MichaelRFairhurst/solver_3/constants.scad

/**
 * Copyright 2018 Mike and Nathan Fairhurst. See LICENSE for licensing.
 */

// Constants to be used by all models
cube_size = 56.5;
$tol = 0.4;
layer_count = 3;
cube_rounding = 1;
servo_block_size=[26.5,15,30];
servo_flange_length=13;
servo_flange_thickness=1.5;
servo_flange_offset=8;
servo_screw_offsets=[3, 5];
servo_screw_size = 4;
servo_gear_teeth_size = 1;
servo_gear_num_teeth = 12;
servo_gear_thickness = 6;

arm_width = 20;
arm_length = 100;

// TODO this does not factor in $tol, and maybe it should.
arm_movement = cube_size / 2 // it has to clear the half of the cube
             // and the grabber, which is long enough to grab all but one layer.
             + (layer_count - 1) * (cube_size/layer_count);

// Dimensional values for use with [ccube], etc.
x = [1, 0, 0];
y = [0, 1, 0];
z = [0, 0, 1];
