MichaelRFairhurst/solver_3/solver_3.scad

/**
 * Copyright 2018 Mike and Nathan Fairhurst. See LICENSE for licensing.
 */
include <constants.scad>;
use <util.scad>;
use <rubiks_cube.scad>;
use <cube_holder.scad>;
use <cube_holder_gear.scad>;
use <frame.scad>;
use <arm.scad>;
use <servo.scad>;
use <gear.scad>;
use <belt.scad>;

// This file is for previewing everything at once. All logic related
// to piece placement & arrangement belongs here; however, any logic
// related to the shape of a piece should be in its own file, one
// per printable piece in most cases.

above_cube_holder() {
  color("red", 0.8) rubiks_cube_on_point();
  color("green", 0.8) onto_point(cube_size) arm(include_gears=false);
}

above_frame() {
  color("white", 0.8)
    up(servo_gear_thickness)
    onto_point()
    cube_holder();

  cube_holder_gear();

  color("grey", 0.8) cube_spinner_servo_placement() servo();
  color("black", 0.8) belt() {
    cube_spinner_servo_placement() servo_gear();
    cube_holder_gear();
  }
}

color("yellow", 0.8) frame();
