MichaelRFairhurst/solver_3/util.scad

/**
 * Copyright 2018 Mike and Nathan Fairhurst. See LICENSE for licensing.
 */

// Constants specific to this file
cube_point_rotation = [45, 35.264, 180];


// Functions to be used by all parts

function is_number(x) = abs(x)!=undef;
function sqr(x) = x*x;
function sqrt(x) = pow(x, 0.5);

// Generate a rotation matrix. You can multiply the result of this function
// to a 3d vector to rotate it in 3d space as if you'd used [rotate].
function rotation(rv)
 = [[cos(rv[2]),-sin(rv[2]),0],[sin(rv[2]),cos(rv[2]),0],[0,0,1]]
 * [[1,0,0],[0,cos(rv[0]),-sin(rv[0])],[0,sin(rv[0]),cos(rv[0])]]
 * [[cos(rv[1]),0,sin(rv[1])],[0,1,0],[-sin(rv[1]),0,cos(rv[1])]];

// Take a point, and put it [onto_point], and return it.
function vec_onto_point(cube_size, vec)
 = vec * rotation(cube_point_rotation)
 + [0, 0, pow(pow(cube_size/2, 2)*3, 1/2)];


// Modules to be used by all parts

// Create a cube balanced on a point. If you want a specialty
// cube, you can use [onto_point] and pass in the size.
module cube_on_point(cube_size) {
  onto_point(cube_size) cube(cube_size, center=true);
}

// Wrap around a cube of [size], and it will be placed on a
// point. Make sure size is accurate, or, when you can, use
// [cube_on_point].
module onto_point(cube_size) {
  translate([0, 0, pow(pow(cube_size/2, 2)*3, 1/2)])
    rotate(cube_point_rotation)
    children();
}

// A cube with rounded corners, with centering available as
// well, via [ccube].
module rounded_cube(size, rounding, center) {
  //realdims = is_number(dims) ? [dims, dims, dims] : dims;
  minkowski() {
    ccube(size - rounding*2, center);
    sphere(r=rounding, center=true, $fn=10);
  }
}

// Move children up by z. Just cleaner than creating a 3d
// vector transform.
module up(z) {
  translate([0, 0, z]) children();
}

// Move children down by z. Just cleaner than creating a 3d
// vector transform.
module down(z) {
  translate([0, 0, -z]) children();
}

// Convenience function for creating a partially centered cube.
//
// [ccube] stands for "centered cube." Rather than having only
// two options (center on all axes or none), the axes upon which
// the cube should be centered can be passed in via the
// constants [x], [y], and [z], from constants.scad. Note you
// can add & subtract these values for a clean API.
//
// Based on [to_center], so if you don't want a cube, or want
// to recreate the transformation of a different [ccube], you
// can use that.
//
// Example: a cube of width 10, centered on x & y
//   ccube(10, x + y)
module ccube(dims, axes) {
  to_center(dims, axes) cube(dims);
}

// The transformation of [ccube], abstracted so that it can be
// used for shapes other than a regular cube.
module to_center(dims, axes) {
  realdims = is_number(dims) ? [dims, dims, dims] : dims;
  translate([
    -realdims[0]/2 * axes[0], 
    -realdims[1]/2 * axes[1], 
    -realdims[2]/2 * axes[2]
  ]) children();
}

// Take a child, and mirror it along the sets of vectors provided. The
// vectors can be the constants [x], [y], and [z] from constants.scad.
//
// Example: Four cubes, evenly mirrored around x and y
//   mirrored([x, y]) translate([10, 10, 0]) cube(1);
module mirrored(vector_set, index = 0) {
  if (index != len(vector_set)) {
    mirror(vector_set[index]) mirrored(vector_set, index + 1) children();
    mirrored(vector_set, index + 1) children();
  } else {
    children();
  }
}
