MichaelRFairhurst/solver_3/(list of files, cad)

Other CAD files:
rubiks_cube.scad
