MichaelRFairhurst/solver_3/(threads)

Thread 1 (2018-01-11):

function to calculate belt placement

MichaelRFairhurst, 2018-01-11:
have a todo in frame.scad, needs to be filled.

IamfromSpace, 2018-01-13:
To get the tangent angle (t) for the two gears we use:
`cos(t) = (1-a/b)/d`
a = smaller gear radius
b = larger gear radius
d = distance between the gears

Then with that, we can calculate the belt circumference (c) we can use
`c = 2 * (a*cos(t) + pi - b*cos(t) + sqrt((b*cos(t) - d - a*cos(t))^2 + (b*sin(t) - a*sin(t)^2))`
(half length of the wrapped gears, distance from one tangent point to another)

However, we want to go the other way.... which appears not to be possible based on [this post](https://math.stackexchange.com/questions/123361/distance-between-two-gears-surrounded-by-a-known-length-belt).

Not totally sure I understand the approximation formula provided, since it seems like `B` is partly what we want to approximate in the first place.

This also seems to have [a simpler belt length formula](http://blog.misumiusa.com/sizing-timing-belts-and-pulleys/).

Closed 2018-01-13.

Thread 10 (2018-01-11):

Design "outer arm" to stabilize middle layer while outer layer spins

MichaelRFairhurst, 2018-01-11:

IamfromSpace, 2018-01-13:
I think we should formalize some names for the servos/claws/holders/hands/arms--and this is really the component that causes the confusion.

Some suggestions:
The "extension" servo/arm
The "face_rotation" servo/arm/claw
The "cube_rotation" servo/holder
The "static_face" claw

Thread 11 (2018-01-11):

"above_cube_holder()" is no longer accurate

MichaelRFairhurst, 2018-01-11:
Because the thickness of the cube holder is perpendicular to the cube faces now, rather than vertical thickness, the cube & arm attached to it etc do not like up with the actual cube holder. Likely just needs to be a change to the above_cube_holder() transformation.

Thread 3 (2018-01-11):

Servo Selection and Modeling

IamfromSpace, 2018-01-11:
Need to select an appropriate servo considering cost/size/torque/quality, and then model it in openscad.

IamfromSpace, 2018-01-14:
### Digital vs Analog
All things equal, digital > analog.  Digital send feedback pulses much much faster.  Changes in desired servo position propagate faster.

However, this is not a big issue for us, as we wont be issuing lots of changes/course corrections mid-motion.  We also don't have a human operator who will "feel" the delay.

### Brushes, Coreless, Brushless
All things being equal brushless > coreless > brushes (though brushless do have higher power draw).  The increased cost however, is likely not worth much for us.  The main advantage seems to come at a coreless design, as these motors last longer (due to less friction from brushes) with very little cost impact.  And our servos will be constantly snapping back and forth, so less wear seems worthwhile.

### Size, Weight, and Power Consumption
Not a practical concern for our application, commodity servos are well within our needs here.

### Speed
Obviously, faster is preferred, all else being equal.  Speed may be something we want to consider, as solving the cube could take up to 80 servo turns.  However, commodity servos seem to have similar speed characteristics.  This is also hard to truly understand the implications of, because speed is measured while _unloaded_.  Yet to find any meaningful explanation for how load affects speed.

### Torque
This is the most important decision, as it's highly correlated with price.  Too low of a torque and the cube may jam, too high a torque and that's unneeded money in the system (barring some impact on speed that was purposefully considered).  Torque is measured in kg*cm, which shows how much weight the servo could lift perpendicular to the ground on a 1cm lever arm (and half that weight at 2cm and so on).  It's not very intuitive to know how much torque is required to rotate the cube, so we'll need to run some experiments.  Other cube solvers seem to use 5kg*cm servos, so that should be a reasonable upper bound.  Also, some cubes are easier to turn than others.  Choice of servo can affect the total build cost for a single solver by ~$12.

Great resource for helping make these judgements here:  https://www.rchelicopterfun.com/rc-servos.html

IamfromSpace, 2018-01-15:
### Torque Test Results
Using the torque_tester from 2e95a670b.  Tested by turning two layers rubbing against cube holder wall.
Fully aligned cube: `0.5kg*cm < t < 0.75kg*cm`
Awkwardly aligned cube: `t < 1.5kg*cm`

Seems reasonable that we could use small servos (1.6kg·cm is a typical spec)--at least worth a try.

IamfromSpace, 2018-01-27:
Some Recent learning:

### Servo Torque Spec Confusion
The SI unit of torque is N·m.  This is how many Newtons of force can be applied at a given lever arm length.  Servos (in metric) are often expressed in kg·cm (or worse, kg/cm which is totally wrong).  The cm instead of m is a simple conversion, but the kg vs N can be quite confusing.  When these torque specs say kg, they mean kg of _weight_, specifically weight on earth.  Weight is _not_ to be confused with mass, but it is certainly confusing.  Weight is a force, mass is mass.  A 1kg object on earth accelerates at 9.8m/s<sup>2</sup>.  F = m·a, so to hold it in place requires a force of 9.8N.

But since that's complicated, servo manufactures just give the _weight_, which assumes a=9.8m/s<sup>2</sup>.  1kg of weight = 9.8N of force.  From here on out I'll try to use N, because it's _not_ simpler when doing more complex things.

## Each Servo is a Bit Different
While at first we were trying to find "one servo to rule them all" it may be worthwhile to look at how each servo differs from one another.  This also helps answer some questions as to arm design (specifically if the arm should include the face turning servo, at a mass penalty).

### The Cube Holder Servo
This servo must rotate the entire cube.  What is interesting about this servo is that it does not have any resisting forces (if we ignore the normal force of the cube·gravity against its mechanism, causing friction).  Unless I'm mistaken, this servo can be of any strength, and it will simply be constrained by the it's maximum acceleration of the cube.

### The Face Turning Servo
This is the servo that has gotten all of the previous attention, so there's currently not much more to say about it.

### The Arm Extension Servo
This servo has the next most interesting properties but has been previously ignored.  There are two forces at work against this servo:
  1. The mass of the arm being lifted at an angle against gravity
  2. The friction of the arm against its container as it moves or begins to move

The servo selection here informs the maximum mass of the arm or vice versa.  This is important because it tells us if we can attach the face turning servo to the arm, or if this servo is over/under specified.

To determine the maximum mass of the arm based on the maximum torque of the arm extension servo is as follows:

where:
μ is the friction coefficient
θ is the angle of the arm (≈54°)
α is the maximum turn angle of the servo in rads
d<sub>e</sub> is the maximum arm extension
τ is the maximum torque of the servo
r is the radius of the servo gear
F<sub>n</sub> is the normal force
F<sub>f</sub> is the frictional force
F is the total force

r = d<sub>e</sub> / α
F<sub>n</sub> = g·m·sinθ
F<sub>f</sub> = μ·g·m·cosθ
F = g·m·sinθ + μ·g·m·cosθ
F = τ / r
m = r·g·(sinθ + μ·cosθ) / τ

if we assume that μ is 0.6, α is 90°, d<sub>e</sub> is 60mm, τ 0.15N·m, the maximum mass of the arm is... TBD.

IamfromSpace, 2018-01-28:
Awesome and simple explanation of DC Motor physics http://lancet.mit.edu/motors/motors3.html

Thread 9 (2018-01-11):

Calculate gap required for cube to spin without hitting the arm

MichaelRFairhurst, 2018-01-11:

IamfromSpace, 2018-01-13:
Because the claw is "open," it appears that just getting the claw "out of the way" of the cube edges, means it will not make any contact on cube rotation.  This is because if you spin the cube on a point, the maximum radius is the edge of a square.

Given this, the total extension distance needs to be: `extension_tolerance + (layer_count - 1) * layer_width + static_claw_depth`.

Closed 2018-01-19.

Thread 20 (2018-01-20):

Micro-Controller Program for Cube Mover

IamfromSpace, 2018-01-20:
Our robot requires three servos, which each require a PWM (pulse width modulated) pin out for control.

While a Raspberry Pi has GP I/O and would be more capable of image processing (an eventual requirement for a self sufficient solver), it only has one hardware PWM.  The other software PWM can be affected by the OS and other applications.  As such, a micro-controller is the preferred way to move the servos.

The micro-controller application needs to accept serial commands to turn cube faces, and keep track of it's orientation.  For parsing ease, we can use Singmaster Notation (U/D/L/R/F/B) to denote cube face, and then an second character to denote the number of 90 degree turns clockwise.  So if the serial input is `F3U1D2`, it would turn the "front" face counter clockwise, the "up" face clockwise, and the "down" face 180 degrees.

Any time this would "reorient" the cube centers, the micro-controller code would take this new orientation into account when it gets the next move.

So each time it decoded the next instruction it would:
 1. Identify "where" the face in question is.
 1. Rotate the cube so that the face is pointing at or away from the claw
 1. Update its internal orientation state based on this rotation
 1. Make the face turn by a series of claw rotations and extensions
 1. Update the internal orientation representation based on center changes.
