MichaelRFairhurst/solver_3/(commit log)

2018-01-08 Servos, gears, and initial servo-to-holder via belt.
    [constants.scad, cube_holder.scad, frame.scad, gear.scad, servo.scad, solver_3.scad, util.scad]
2018-01-08 Simple belt mechanism, belt drawn between servo & cube holder
    [belt.scad, cube_holder.scad, frame.scad, servo.scad, solver_3.scad]
2018-01-11 Cube measurements, adjustments to that, and improved cube holder
    [arm.scad, constants.scad, cube_holder.scad, frame.scad, util.scad]
2018-01-11 Add margin to cube holder; place cube holder servo by belt size
    [belt.scad, cube_holder.scad, frame.scad, solver_3.scad, util.scad]
2018-01-13 opposing gears on arm -- currently the whole length (#12)
    opposing gears on arm -- currently the whole length
    non-gear arm mode for frame punching and preview speed
    [arm.scad, frame.scad, gear.scad, solver_3.scad]
2018-01-14 Fix #1. Use an approximation to calculate the distance between the center point of two gears surrounded by a belt of known length. (#13)
    [belt.scad, frame.scad]
2018-01-16 Larger gear sizes on the arm, frame to compensate for that (#14)
    [arm.scad, frame.scad]
2018-01-17 Create a rudimentary torque testing helper. (#16)
    [constants.scad, torque_tester.scad]
2018-01-18 Update cube size based on caliper measurements. (#19)
    * Update cube size based on caliper measurements.
    * Use a special variable for tolerance, and update the torque_tester to use it.
    [constants.scad, torque_tester.scad]
2018-01-21 Flat print holder (#17)
    Flatten, separate out models, and use pins.
    [constants.scad, cube_holder.scad, cube_holder_gear.scad, pin.scad, solver_3.scad]
2018-01-21 Make an arm assembly aspect of the frame.
    Some TODOs. Also, depends on separate-arm-and-claw.
    [arm.scad, constants.scad, frame.scad, util.scad]
